Aleksei327/STM32F103-INA226-ST7735-Indicator-Encoder-Protection-PS/Core/Src/main.c

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

/* Includes ------------------------------------------------------------------*/
#include "main.h"
#include "spi.h"
#include "gpio.h"

/* USER CODE BEGIN Includes */
#include "fonts.h"
#include "st7735.h"
#include <stdio.h>
#include <stdlib.h>   // ← ДОБАВЬ ЭТУ СТРОКУ для функции abs()
#include "ina226.h"
#include "soft_i2c.h"
#include "encoder.h"
/* USER CODE END Includes */

/* USER CODE BEGIN PV */

TIM_HandleTypeDef htim2; //переменная таймера



// Текущий лимит тока (настраивается энкодером)
static float current_limit = 0.150f;  // По умолчанию 0.150A

// Флаг срабатывания Alert
static uint8_t alert_triggered = 0;

// Для мигания экрана при Alert
static uint32_t last_blink_time = 0;
static uint8_t blink_state = 0;

/* USER CODE END PV */


void SystemClock_Config(void);
void UpdateDisplay(float v_val, float i_val, float power, float capacity_ah);
// Теперь функция принимает значения напряжения и тока:
void HandleAlertIndication(float v, float i);
void MX_TIM2_Init(void);

// Добавь эти строки, чтобы компилятор знал про пищалку:
void Buzzer_On(void);
void Buzzer_Off(void);
/**
  * @brief  The application entry point.
  * @retval int
  */
int main(void)
{
  /* MCU Configuration--------------------------------------------------------*/
  HAL_Init();

  /* Configure the system clock */
  SystemClock_Config();

  /* Initialize all configured peripherals */
  MX_GPIO_Init();
  MX_SPI1_Init();
  MX_TIM2_Init();
  /* USER CODE BEGIN 2 */

  // Инициализация дисплея
  ST7735_Init();

  // Инициализация программного I2C
  Soft_I2C_Init();

  // Инициализация энкодера и кнопки
  Encoder_Init();

  // === ТЕСТ ПИЩАЛКИ ===
    // Если при включении будет ПИИИИП - значит таймер настроен верно,
    // и проблема только в логике Alert.
    Buzzer_On();        // Включить ШИМ
    HAL_Delay(500);     // Ждать полсекунды
    Buzzer_Off();       // Выключить ШИМ
    // ====================

  // Приветственный экран
  ST7735_FillScreen(ST7735_BLACK);
  ST7735_WriteString(10, 50, "LBP Indicator", Font_11x18, ST7735_WHITE, ST7735_BLACK);
  ST7735_WriteString(20, 75, "v1.1", Font_7x10, ST7735_GREEN, ST7735_BLACK);
  HAL_Delay(1500);

  // Проверка INA226
  ST7735_FillScreen(ST7735_BLACK);
  ST7735_WriteString(5, 10, "Init INA226...", Font_7x10, ST7735_CYAN, ST7735_BLACK);

  if (Soft_I2C_IsDeviceReady(INA226_ADDR) == 0) {
      ST7735_WriteString(5, 25, "INA226 OK!", Font_7x10, ST7735_GREEN, ST7735_BLACK);
  } else {
      ST7735_WriteString(5, 25, "INA226 FAIL!", Font_7x10, ST7735_RED, ST7735_BLACK);
      while(1); // Останавливаемся если INA226 не найдена
  }

  HAL_Delay(500);

  // Инициализация INA226
  INA226_Init(NULL);

  // Настройка Alert
  INA226_SetCurrentLimit(current_limit);
  INA226_EnableCurrentAlert();

  ST7735_WriteString(5, 40, "Alert enabled", Font_7x10, ST7735_YELLOW, ST7735_BLACK);
  char msg[32];
  sprintf(msg, "Limit: %.2fA", current_limit);
  ST7735_WriteString(5, 55, msg, Font_7x10, ST7735_YELLOW, ST7735_BLACK);
  HAL_Delay(500);

  // Очищаем экран для основного режима
  ST7735_FillScreen(ST7735_BLACK);

  // Переменные для измерений
  float v_val = 0.0f;
  float i_val = 0.0f;
  float power = 0.0f;
  float capacity_ah = 0.0f;

  /* USER CODE END 2 */

  /* Infinite loop */
  /* USER CODE BEGIN WHILE */
  while (1)
  {
	  // ==================== ОБРАБОТКА ЭНКОДЕРА ====================
	  int16_t encoder_delta = Encoder_GetDelta();

	  if (encoder_delta != 0) {
	      // Адаптивный шаг в зависимости от скорости вращения
	      float step;

	      if (abs(encoder_delta) > 4) {
	          // Быстрое вращение - шаг 0.1A
	          step = 0.1f;
	      } else {
	          // Медленное вращение - шаг 0.01A
	          step = 0.01f;
	      }

	      current_limit += encoder_delta * step;

	      // Ограничиваем диапазон
	      if (current_limit < 0.01f) current_limit = 0.01f;
	      if (current_limit > 2.35f) current_limit = 2.35f;

	      // Применяем новый лимит
	      INA226_SetCurrentLimit(current_limit);
	  }

	  // ==================== ПРОВЕРКА ALERT ====================
	  // КЛЮЧЕВОЕ ИЗМЕНЕНИЕ: проверяем только если защита еще НЕ активна
	  if (!alert_triggered) {
	      if (INA226_IsAlertTriggered()) {
	          alert_triggered = 1;
	          // Здесь защелка сработала, и так как мы больше НЕ заходим в это условие,
	          // регистр 0x06 больше не читается, и ПИН ALERT остается в "0" навсегда.
	      }
	  }


	  // ==================== КНОПКА СБРОСА ALERT ====================
	  if (ResetButton_IsPressed()) {
	      // 1. Сбрасываем железную защелку внутри ИНЫ (однократное чтение регистра 0x06)
	      INA226_ClearAlert();

	      // 2. Сбрасываем программный флаг
	      alert_triggered = 0;

	      // 3. Выключаем звук
	      Buzzer_Off();

	      // 4. Очищаем экран для возврата в нормальный режим
	      ST7735_FillScreen(ST7735_BLACK);

	      // 5. На всякий случай обновляем настройки в ИНЕ
	      INA226_EnableCurrentAlert();
	  }





    // ==================== ЧТЕНИЕ ДАННЫХ ====================
    v_val = INA226_ReadBusVoltage();
    i_val = INA226_ReadCurrent();
    power = INA226_ReadPower();

    // Интегрирование тока для расчёта ёмкости
    capacity_ah += (i_val * 0.1f) / 3600.0f;  // 100мс опрос







    // ==================== ОБНОВЛЕНИЕ ЭКРАНА ====================
        if (alert_triggered) {
          // Передаем текущие значения v_val и i_val в функцию
          HandleAlertIndication(v_val, i_val);
        } else {
          UpdateDisplay(v_val, i_val, power, capacity_ah);
        }

    HAL_Delay(1);  // Обновление 10 раз в секунду

    /* USER CODE END WHILE */

    /* USER CODE BEGIN 3 */
  }
  /* USER CODE END 3 */
}

/* USER CODE BEGIN 4 */

/**
 * Обновление дисплея в нормальном режиме
 */
void UpdateDisplay(float v_val, float i_val, float power, float capacity_ah) {
  char str[40];

  // ==================== НАПРЯЖЕНИЕ ====================
  // Позиция: верх экрана
  sprintf(str, "%6.3f V", v_val);
  ST7735_WriteString(15, 10, str, Font_16x26, ST7735_RED, ST7735_BLACK);

  // ==================== ТОК ====================
  // Позиция: под напряжением
  sprintf(str, "%6.3f A", i_val);
  ST7735_WriteString(15, 40, str, Font_16x26, ST7735_BLUE, ST7735_BLACK);

  // ==================== ЛИМИТ ТОКА (регулируется энкодером) ====================
  // Позиция: ниже тока
  ST7735_WriteString(10, 72, "Limit:", Font_11x18, ST7735_WHITE, ST7735_BLACK);
  sprintf(str, "%.3fA", current_limit);
  ST7735_WriteString(78, 72, str, Font_11x18, ST7735_WHITE, ST7735_BLACK);

  // ==================== МОЩНОСТЬ И ЁМКОСТЬ ====================
  // Позиция: внизу экрана
  sprintf(str, "%.2fW %.3fAh", power, capacity_ah);
  ST7735_WriteString(10, 100, str, Font_11x18, ST7735_GREEN, ST7735_BLACK);
}

/**
 * Индикация срабатывания Alert
 */
void HandleAlertIndication(float v, float i) {
  uint32_t current_tick = HAL_GetTick();

  // ==================== ЦИКЛ МИГАНИЯ И ПИСКА (500мс) ====================
  if (current_tick - last_blink_time > 500) {
    last_blink_time = current_tick;
    blink_state = !blink_state;

    if (blink_state) {
      // ЭКРАН ЗАГОРЕЛСЯ -> ВКЛЮЧАЕМ ЗВУК
      Buzzer_On();
      uint16_t bg_color = 0xFCE0; // Розовый
      ST7735_FillScreen(bg_color);
      ST7735_WriteString(25, 15, "ALERT!", Font_16x26, ST7735_RED, bg_color);

      char str[40];
            // Теперь используем переменные v и i, которые пришли в функцию
            sprintf(str, "V: %6.3f V", v);
            ST7735_WriteString(15, 50, str, Font_11x18, ST7735_BLACK, bg_color);

            sprintf(str, "I: %6.3f A", i);
            ST7735_WriteString(15, 70, str, Font_11x18, ST7735_BLACK, bg_color);

            sprintf(str, "Limit: %.2fA", current_limit);
            ST7735_WriteString(20, 95, str, Font_11x18, ST7735_BLUE, bg_color);
            ST7735_WriteString(10, 115, "Press to reset", Font_7x10, ST7735_YELLOW, bg_color);
          }
    else {
      // ЭКРАН ПОГАС (ЧЕРНЫЙ) -> ВЫКЛЮЧАЕМ ЗВУК
      Buzzer_Off();
      ST7735_FillScreen(ST7735_BLACK);
      // На черном фоне текст можно не писать, чтобы быстрее мерцало
    }
  }
}

/* USER CODE END 4 */

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
