Aleksei327/STM32F103-INA226-ST7735-Indicator-Encoder-Protection-PS/Core/Inc/main.h

#define ST7735_RES_Pin GPIO_PIN_0
#define ST7735_RES_GPIO_Port GPIOB
#define ST7735_DC_Pin GPIO_PIN_1
#define ST7735_DC_GPIO_Port GPIOB
#define ST7735_CS_Pin GPIO_PIN_10
#define ST7735_CS_GPIO_Port GPIOB
