Aleksei327/STM32F103-INA226-ST7735-Indicator-Encoder-Protection-PS/(commit log)

2026-02-01 Revise README with new project details and features
    Updated project title and expanded description with key features, technical configuration, and critical assembly notes.
2026-02-12 Update shunt resistor value in README.md
