Aleksei327/STM32F103-INA226-ST7735-Indicator-Encoder-Protection-PS/(notices)

Notices in the files:
Core/Inc/main.h:
Copyright (c) 2026 STMicroelectronics.
All rights reserved.
This software is licensed under terms that can be found in the LICENSE file
